Uwita082/ris-dac-voltage-supply/Circuit schematic/Schematic_Research Project_2025-06-20.pdf

# U15 PG¹

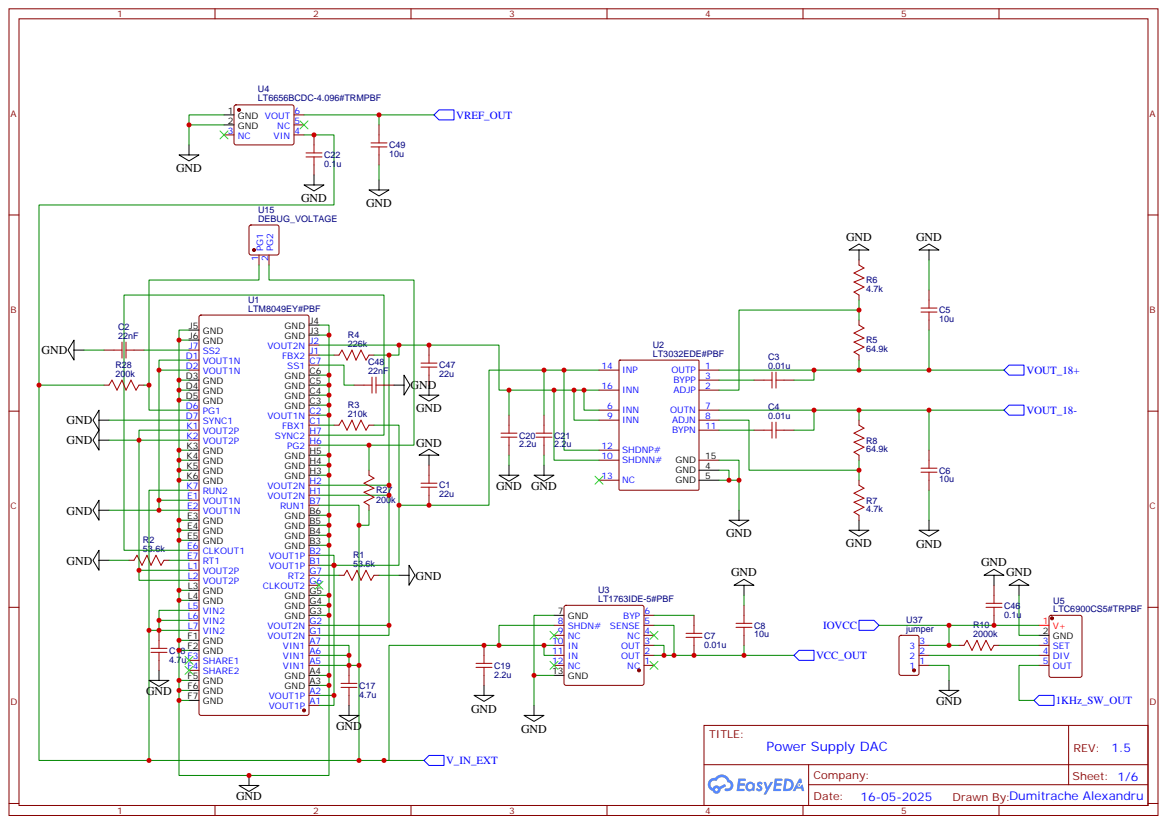
[picture p1: page 1]

DEBUG_VOLTAGE
VOUT1P A1 VOUT1P A2 GND A3 GND A4 VIN1 A5 VIN1 A6 VIN1 A7 VOUT2N G1 VOUT2N G2 GND G3 GND G4 GND G5 CLKOUT2 G6 RT2 G7 VOUT1P B1 VOUT1P B2 GND B3 GND B4 GND B5 GND B6 RUN1 B7 VOUT2N H1 VOUT2N H2 GND H3 GND H4 GND H5 PG2 H6 SYNC2 H7 FBX1 C1 VOUT1N C2 GND C3 GND C4 GND C5 GND C6 SS1 C7 FBX2 J1 VOUT2N J2 GND J3 GND J4

GND 7
SHDN# 8
GND 13 NC 12 IN 11 IN 10 NC 9

Drawn By:Dumitrache Alexandru

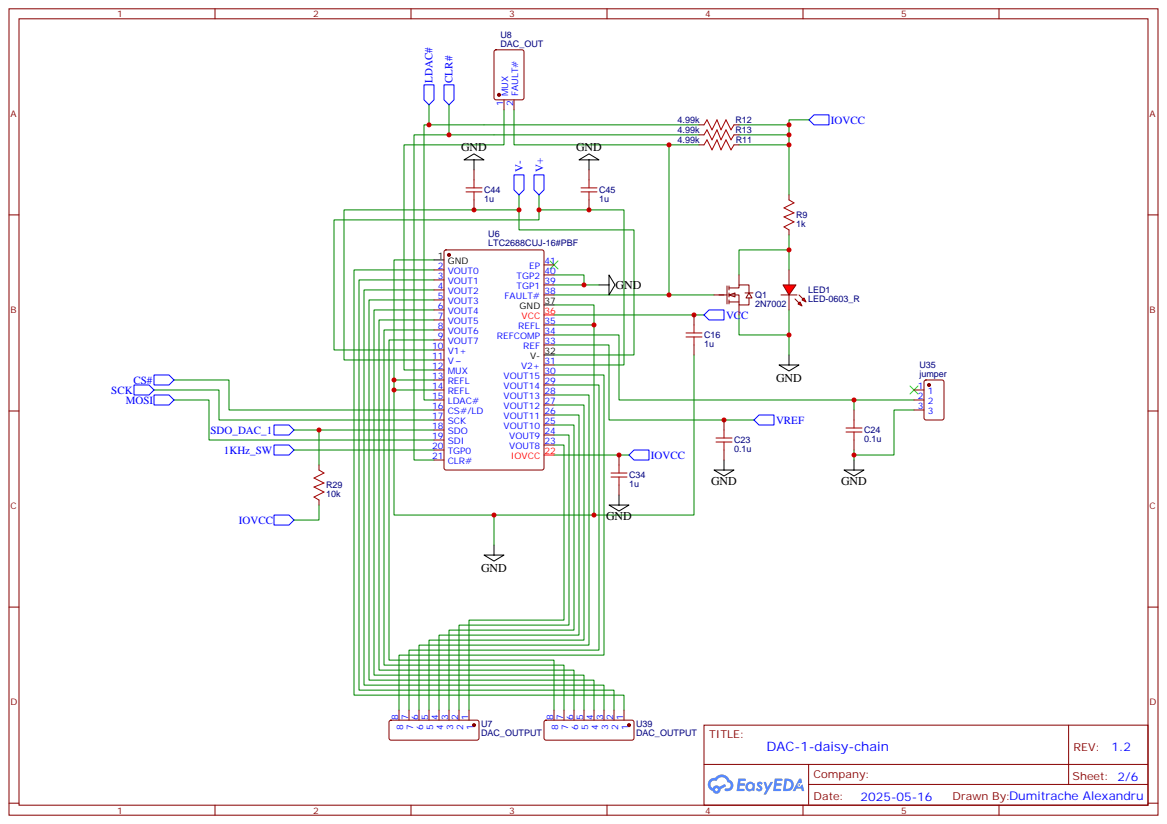
[picture p2: page 2]

## U12MUX

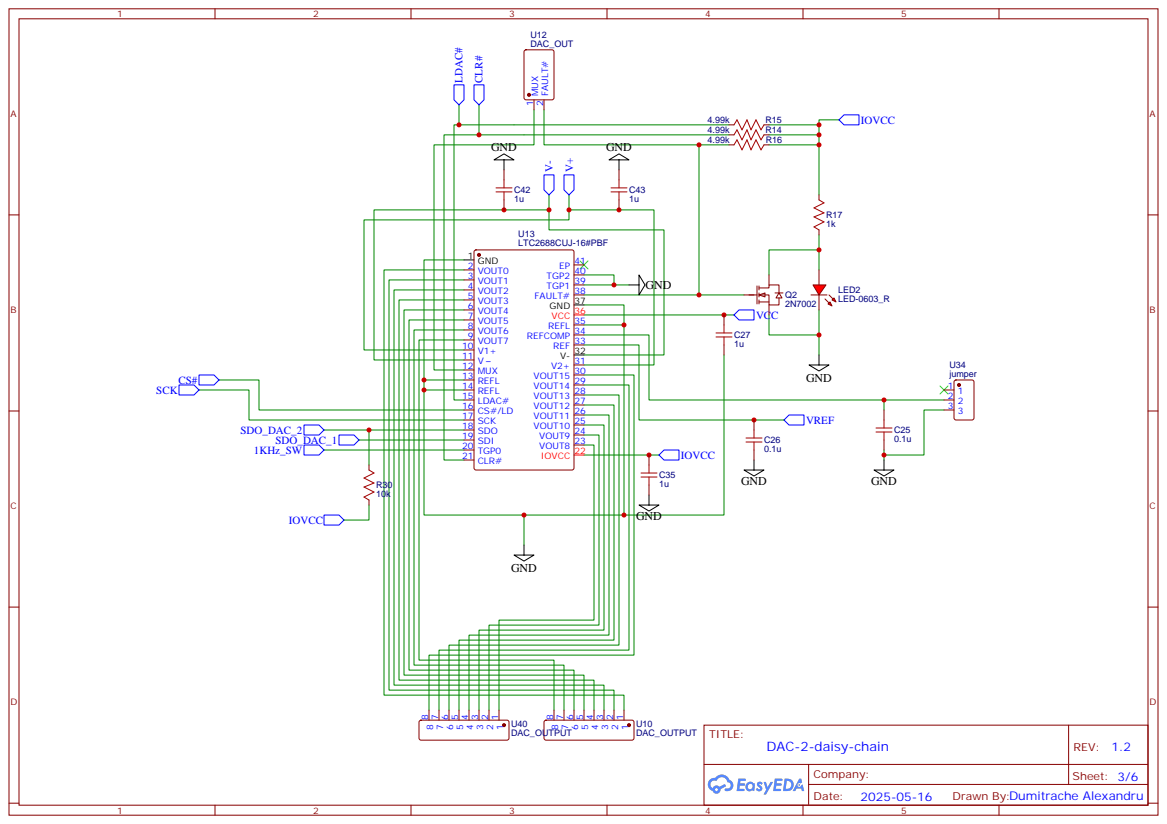
[picture p3: page 3]

## U14MUX

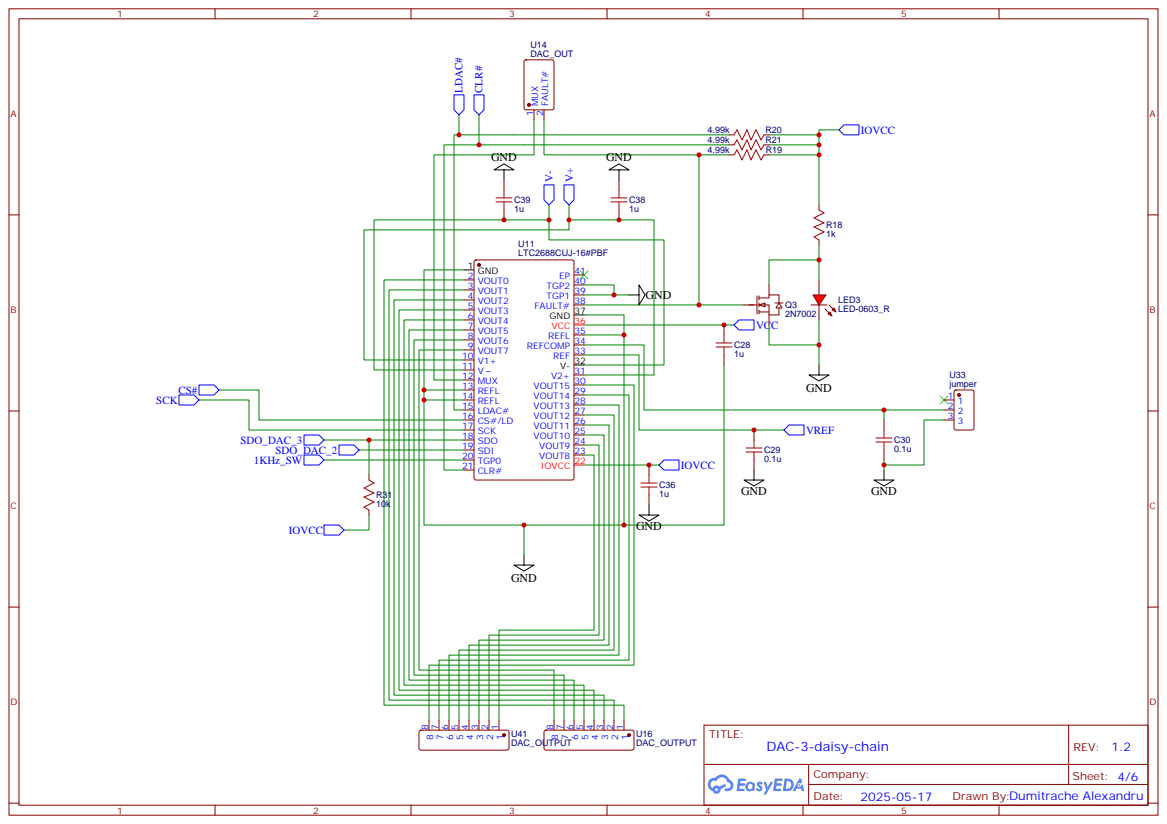
[picture p4: page 4]

## U36MUX

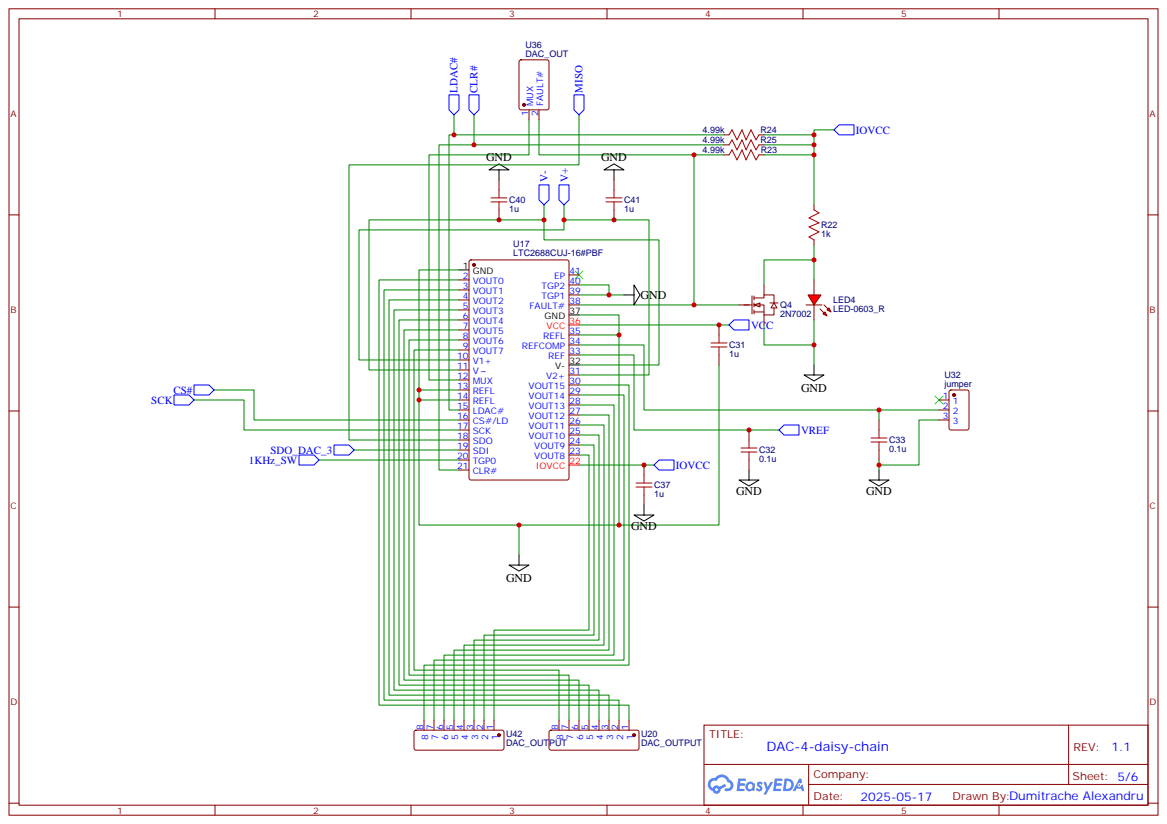
[picture p5: page 5]

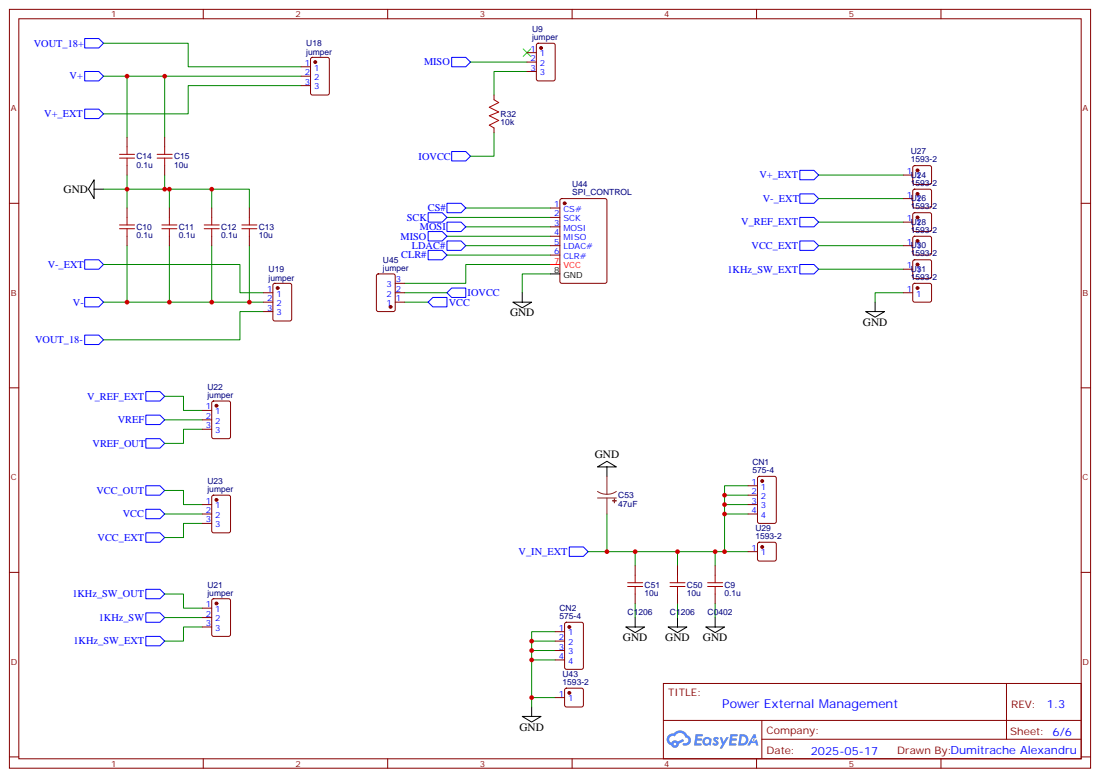
[picture p6: page 6]
