Uwita082/ris-dac-voltage-supply/PCB/PCB_Assembly_Research Project_2025-06-20.pdf

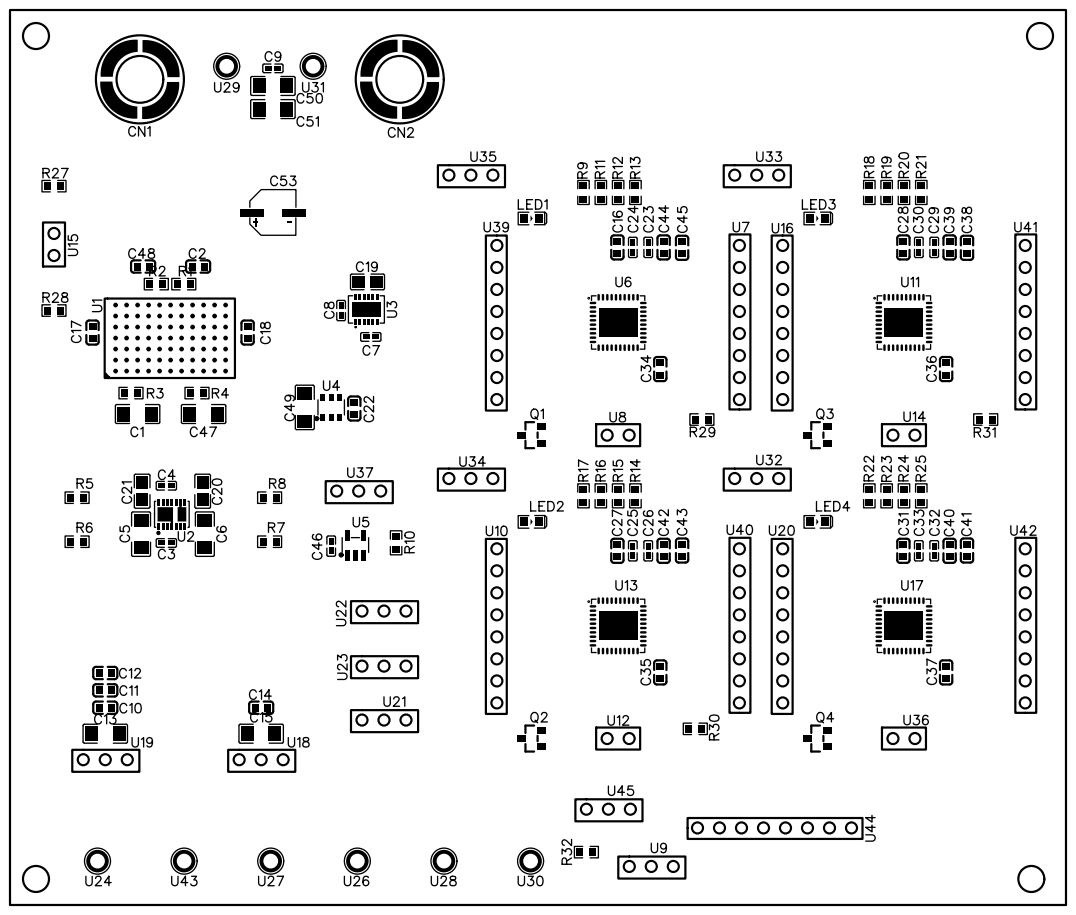
[picture p7: page 1]
