Uwita082/ris-dac-voltage-supply/Simulations/LTM8049 with LT3032.asc

C1: cap; 22µ; Rser=5m
C2: cap; 22µ; Rser=5m
C3: cap; 4.7µ
C4: cap; 4.7µ
C5: cap; 10µ
C6: cap; 22µ; Rser=5m
C7: cap; 0.01µ
C8: cap; 0.01µ
C9: cap; 10µ
C10: cap; 10µ
C11: cap; 0.01µ
C12: cap; 10µ
C13: cap; 22µ; Rser=5m
R1: res; 53.6K
R2: res; 207k
R3: res; 53.6K
R4: res; 222k
R5: res; 140K
R6: res; 140K
R7: res; 10K
R8: res; 10K
R9: res; 100
R10: res; 100
R11: res; 100
R12: res; 1000
U1: LTM8049
U2: LT3032
U3: LT1763-5
U4: LT6656-4.096
V1: voltage; 12
Named nets: 0, OUT_LOGIC, OUT_V+, OUT_V-, OUT_REF
6V to 18V
.tran 100m startup
