Uwita082/ris-dac-voltage-supply/Simulations/Voltage_Supply_Part_1.asc

C1: cap; 2.2µ
C2: cap; 2.2µ
C3: cap; 0.01µ
C4: cap; 0.01µ
C5: cap; 10µ
C6: cap; 10µ
C7: cap; 0.1µ
C8: cap; 10µ
C9: cap; 10µ
C10: cap; 2.2µ
C11: cap; 0.01µ
C12: cap; 10µ
C13: cap; 0.1µ
C14: cap; 10µ
C15: cap; 0.1µ
R1: res; 4.7k
R2: res; 4.7k
R3: res; 64.9k
R4: res; 64.9k
R5: res; 2000K
U1: LT3032
U2: LT1763-5
U3: LT6656-4.096
U4: LTC6900
V1: voltage; +18.7
V2: voltage; -18.8
V3: voltage; 6
Named nets: 0, VOUT_18+, VOUT_18-, V_IN_EXT, VCC_OUT, VREF_OUT, 1KHz_SW_OUT
.tran 5 startup
