Uwita082/ris-dac-voltage-supply/(list of files, drawings)

Other design files:
Circuit schematic/SCH_Research Project_2025-06-20.json
PCB/PCB_PCB_Research Project_2025-06-20.json
