Uwita082/ris-dac-voltage-supply/codes/raspberry-pi-pico/src/protocol/protocol_mock.py

class ProtocolMock:
    def open(self) -> None:
        pass

    def close(self) -> None:
        pass

    def write(self, byte_list: bytearray)  -> None:
        print(byte_list)
        bits = ''.join(f'{byte:08b}' for byte in byte_list)
        print(bits)
        print("\n")
