Uwita082/ris-dac-voltage-supply/(commit log)

2025-06-12 Update for Raspberry Pi 5
2025-06-12 Add fix for settings
    [main.py, protocol_service.py]
2025-06-12 Fix bugs with transmission
    [protocol_service.py, protocol_spidev.py]
2025-06-12 Close the SPI connection
2025-06-14 Add code for Raspberry Pi Pico
2025-06-14 Add manual control of CS pin for the raspberry pi 5 version
2025-06-15 Add setup commands for C code SPI
2025-06-17 Fix bug while loop
    [protocol_service.py]
2025-06-20 Add schematics
    [PCB_PCB_Research Project_2025-06-20.json, SCH_Research Project_2025-06-20.json]
2025-06-22 Add PCB README.md file
